fortunelabs-io/fortunelabs-mainboard-l/hardware/fortunelabs_mainboard_v0/fortunelabs_mainboard_v0.kicad_sch

## KiCad design hardware/fortunelabs_mainboard_v0/fortunelabs_mainboard_v0.kicad_sch (2026-08-21, an earlier design)

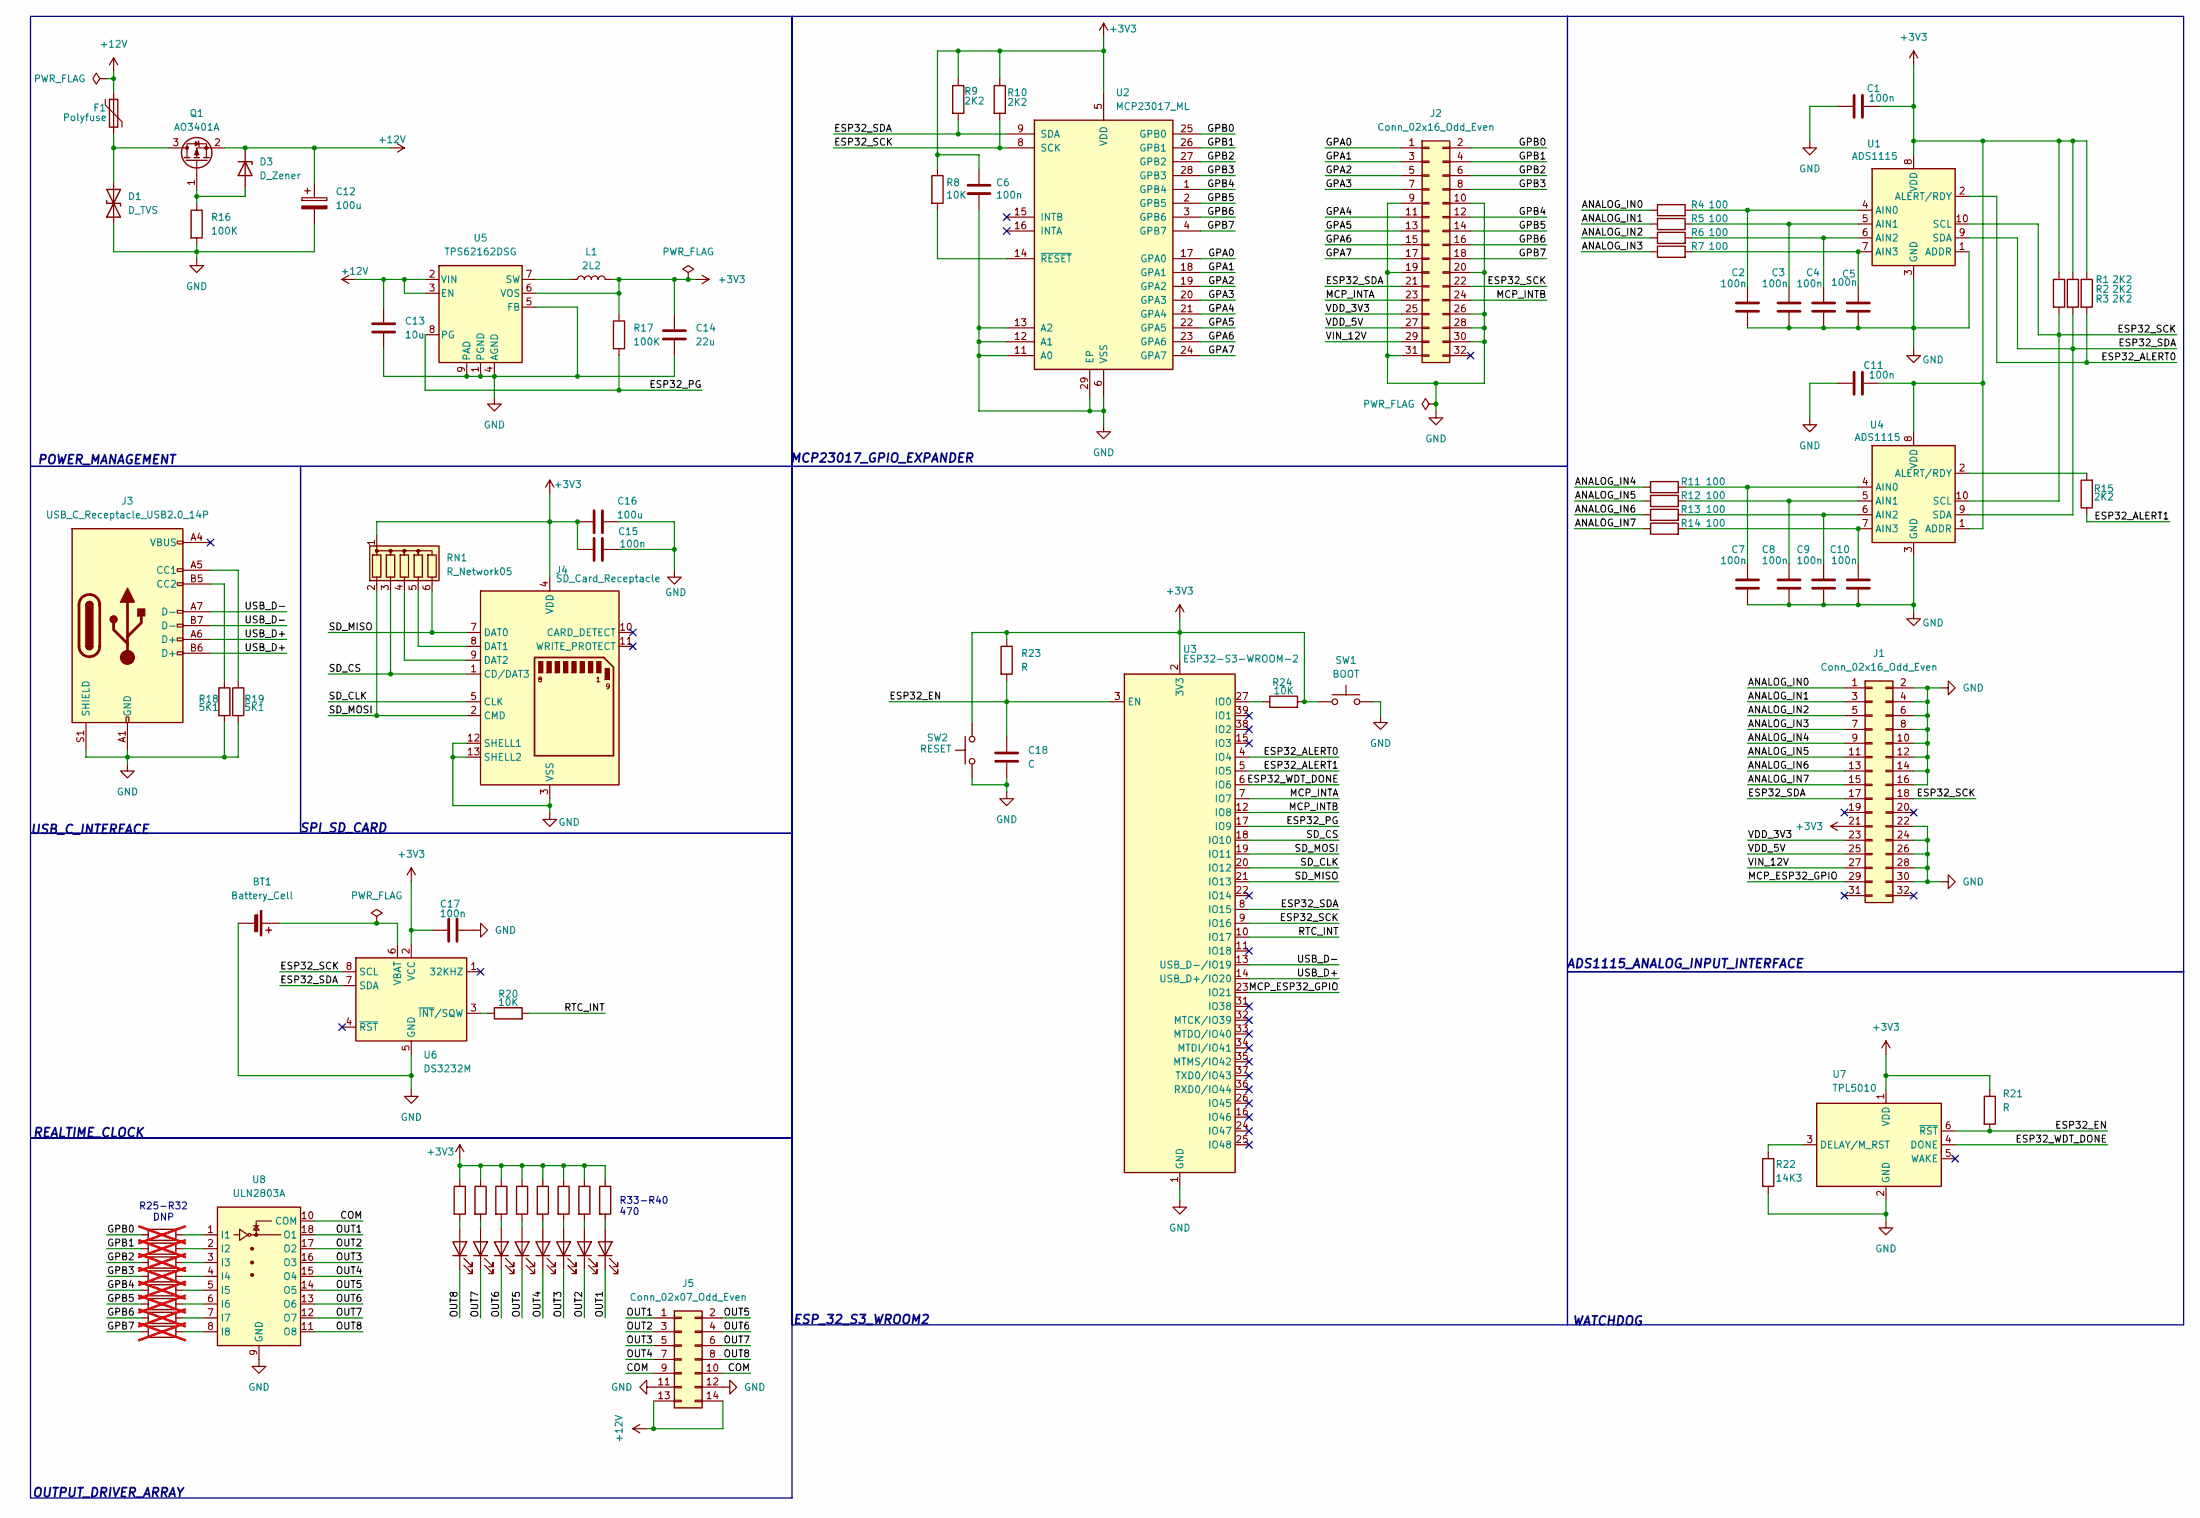
[picture p1: schematic fortunelabs_mainboard_v0.kicad_sch]

Parts:
BT1: Battery_Cell; BatteryHolder_Keystone_3002_1x2032
C1, C2, C3, C4, C5, C6, C7, C8, C9, C10, C11, C15, C17: 100n
C12, C16: 100u
C13: 10u
C14: 22u
C18: C
D1: D_TVS
D2, D4, D5, D6, D7, D8, D9: LED
D3: D_Zener
D10: LED; LED_0805_2012Metric
F1: Polyfuse
J1, J2: Conn_02x16_Odd_Even
J3: USB_C_Receptacle_USB2.0_14P
J4: SD_Card_Receptacle
J5: Conn_02x07_Odd_Even
L1: 2L2
Q1: AO3401A; SOT-23
R1, R2, R3, R9, R10, R15: 2K2
R4, R5, R6, R7, R11, R12, R13, R14: 100
R8, R20, R24: 10K
R16, R17: 100K
R18, R19: 5K1
R21, R23: R
R22: 14K3
R25, R26, R27, R28, R29, R30, R31, R32: DNP; not fitted
R33, R34, R35, R36, R37, R38, R39, R40: 470
RN1: R_Network05; R_Array_SIP6
SW1: BOOT
SW2: RESET
U1, U4: ADS1115; TSSOP-10_3x3mm_P0.5mm
U2: MCP23017_ML; QFN-28-1EP_6x6mm_P0.65mm_EP4.25x4.25mm
U3: ESP32-S3-WROOM-2
U5: TPS62162DSG; WSON-8-1EP_2x2mm_P0.5mm_EP0.9x1.6mm_ThermalVias
U6: DS3232M; SOIC-8_3.9x4.9mm_P1.27mm
U7: TPL5010; SOT-23-6
U8: ULN2803A

Connections:
+3V3: C1.1, C6.1, C11.1, C14.2, C15.1, C16.1, C17.1, J1.21, J4.4 (VDD), L1.2, R1.1, R2.1, R3.1, R8.1, R9.1, R10.1, R17.1, R21.1, R23.1, R24.2, R33.1, R34.1, R35.1, R36.1, R37.1, R38.1, R39.1, R40.1, RN1.1 (common), SW1.1, SW2.2, U1.8 (VDD), U2.5 (VDD), U3.2 (3V3), U4.1 (ADDR), U4.8 (VDD), U5.6 (VOS), U6.2 (VCC), U7.1 (VDD)
+12V: C12.1, C13.1, D3.1 (K), F1.1, J5.13, J5.14, Q1.2 (S), U5.2 (VIN), U5.3 (EN)
ANALOG_IN0: J1.1, R4.1
ANALOG_IN1: J1.3, R5.1
ANALOG_IN2: J1.5, R6.1
ANALOG_IN3: J1.7, R7.1
ANALOG_IN4: J1.9, R11.1
ANALOG_IN5: J1.11, R12.1
ANALOG_IN6: J1.13, R13.1
ANALOG_IN7: J1.15, R14.1
COM: J5.9, J5.10, U8.10 (COM)
ESP32_ALERT0: R1.2, U1.2 (ALERT/RDY), U3.4 (IO4)
ESP32_ALERT1: R15.1, U3.5 (IO5)
ESP32_EN: C18.1, R21.2, R23.2, U3.3 (EN), U7.6 (~RST)
ESP32_PG: R17.2, U3.17 (IO9), U5.8 (PG)
ESP32_SCK: J1.18, J2.22, R3.2, R10.2, U1.10 (SCL), U2.8 (SCK), U3.9 (IO16), U4.10 (SCL), U6.8 (SCL)
ESP32_SDA: J1.17, J2.21, R2.2, R9.2, U1.9 (SDA), U2.9 (SDA), U3.8 (IO15), U4.9 (SDA), U6.7 (SDA)
ESP32_WDT_DONE: U3.6 (IO6), U7.4 (DONE)
GND: BT1.2 (-), C1.2, C2.2, C3.2, C4.2, C5.2, C6.2, C7.2, C8.2, C9.2, C10.2, C11.2, C12.2, C13.2, C14.1, C15.2, C16.2, C17.2, C18.2, D1.1 (A1), J1.2, J1.4, J1.6, J1.8, J1.10, J1.12, J1.14, J1.16, J1.22, J1.24, J1.26, J1.28, J1.30, J2.9, J2.10, J2.19, J2.20, J2.26, J2.28, J2.30, J2.31, J3.A1 (GND), J3.A12 (GND), J3.B1 (GND), J3.B12 (GND), J3.S1 (SHIELD), J4.3 (VSS), J4.6 (VSS), J4.12 (SHELL1), J4.13 (SHELL2), J5.11, J5.12, R16.2, R18.2, R19.2, R22.2, SW1.2, SW2.1, U1.1 (ADDR), U1.3 (GND), U2.6 (VSS), U2.11 (A0), U2.12 (A1), U2.13 (A2), U2.29 (EP), U3.1 (GND), U3.40 (GND), U3.41 (GND), U4.3 (GND), U5.1 (PGND), U5.4 (AGND), U5.5 (FB), U5.9 (PAD), U6.5 (GND), U7.2 (GND), U8.9 (GND)
GPA0: J2.1, U2.17 (GPA0)
GPA1: J2.3, U2.18 (GPA1)
GPA2: J2.5, U2.19 (GPA2)
GPA3: J2.7, U2.20 (GPA3)
GPA4: J2.11, U2.21 (GPA4)
GPA5: J2.13, U2.22 (GPA5)
GPA6: J2.15, U2.23 (GPA6)
GPA7: J2.17, U2.24 (GPA7)
GPB0: J2.2, R25.1, U2.25 (GPB0)
GPB1: J2.4, R26.1, U2.26 (GPB1)
GPB2: J2.6, R27.1, U2.27 (GPB2)
GPB3: J2.8, R28.1, U2.28 (GPB3)
GPB4: J2.12, R29.1, U2.1 (GPB4)
GPB5: J2.14, R30.1, U2.2 (GPB5)
GPB6: J2.16, R31.1, U2.3 (GPB6)
GPB7: J2.18, R32.1, U2.4 (GPB7)
MCP_ESP32_GPIO: J1.29, U3.23 (IO21)
MCP_INTA: J2.23, U3.7 (IO7)
MCP_INTB: J2.24, U3.12 (IO8)
unnamed: BT1.1 (+), U6.6 (VBAT)
unnamed: C2.1, R4.2, U1.4 (AIN0)
unnamed: C3.1, R5.2, U1.5 (AIN1)
unnamed: C4.1, R6.2, U1.6 (AIN2)
unnamed: C5.1, R7.2, U1.7 (AIN3)
unnamed: C7.1, R11.2, U4.4 (AIN0)
unnamed: C8.1, R12.2, U4.5 (AIN1)
unnamed: C9.1, R13.2, U4.6 (AIN2)
unnamed: C10.1, R14.2, U4.7 (AIN3)
unnamed: D1.2 (A2), F1.2, Q1.3 (D)
unnamed: D2.2 (A), R33.2
unnamed: D3.2 (A), Q1.1 (G), R16.1
unnamed: D4.2 (A), R34.2
unnamed: D5.2 (A), R35.2
unnamed: D6.2 (A), R36.2
unnamed: D7.2 (A), R37.2
unnamed: D8.2 (A), R38.2
unnamed: D9.2 (A), R39.2
unnamed: D10.2 (A), R40.2
unnamed: J3.A4 (VBUS), J3.A9 (VBUS), J3.B4 (VBUS), J3.B9 (VBUS)
unnamed: J3.A5 (CC1), R19.1
unnamed: J3.B5 (CC2), R18.1
unnamed: J4.8 (DAT1), RN1.5 (R4)
unnamed: J4.9 (DAT2), RN1.4 (R3)
unnamed: L1.1, U5.7 (SW)
unnamed: R8.2, U2.14 (~RESET)
unnamed: R15.2, U4.2 (ALERT/RDY)
unnamed: R20.1, U6.3 (~INT/SQW)
unnamed: R22.1, U7.3 (DELAY/M_RST)
unnamed: R24.1, U3.27 (IO0)
unnamed: R25.2, U8.1 (I1)
unnamed: R26.2, U8.2 (I2)
unnamed: R27.2, U8.3 (I3)
unnamed: R28.2, U8.4 (I4)
unnamed: R29.2, U8.5 (I5)
unnamed: R30.2, U8.6 (I6)
unnamed: R31.2, U8.7 (I7)
unnamed: R32.2, U8.8 (I8)
OUT1: D10.1 (K), J5.1, U8.18 (O1)
OUT2: D9.1 (K), J5.3, U8.17 (O2)
OUT3: D8.1 (K), J5.5, U8.16 (O3)
OUT4: D7.1 (K), J5.7, U8.15 (O4)
OUT5: D6.1 (K), J5.2, U8.14 (O5)
OUT6: D5.1 (K), J5.4, U8.13 (O6)
OUT7: D4.1 (K), J5.6, U8.12 (O7)
OUT8: D2.1 (K), J5.8, U8.11 (O8)
RTC_INT: R20.2, U3.10 (IO17)
SD_CLK: J4.5 (CLK), U3.20 (IO12)
SD_CS: J4.1 (CD/DAT3), RN1.3 (R2), U3.18 (IO10)
SD_MISO: J4.7 (DAT0), RN1.6 (R5), U3.21 (IO13)
SD_MOSI: J4.2 (CMD), RN1.2 (R1), U3.19 (IO11)
USB_D+: J3.A6 (D+), J3.B6 (D+), U3.14 (USB_D+/IO20)
USB_D-: J3.A7 (D-), J3.B7 (D-), U3.13 (USB_D-/IO19)
VDD_3V3: J1.23, J2.25
VDD_5V: J1.25, J2.27
VIN_12V: J1.27, J2.29

Notes on the sheet:
R33-R40 470
MCP23017_GPIO_EXPANDER
ADS1115_ANALOG_INPUT_INTERFACE
POWER_MANAGEMENT
ESP_32_S3_WROOM2
USB_C_INTERFACE
WATCHDOG
OUTPUT_DRIVER_ARRAY
SPI_SD_CARD
R25-R32 DNP
REALTIME_CLOCK
