fortunelabs-io/fortunelabs-mainboard-l/(commit log)

2026-07-07 refactor: i2c bus defense mechanism and adding abstaction in IOCON.BANK1 MCP23017
2026-07-07 feat: init SIL test for i2c pipeline
2026-07-08 fix: resolving SIL symlink dir
    [ads1115.c, ads1115.h, esp_err.h, esp_log.h, mcp23017.c, mcp23017.h]
2026-07-21 feat(hardware): add KiCad mainboard v0 project with git workflow
    - fortunelabs_mainboard_v0.kicad_pro/sch/pcb
    - .gitignore for KiCad backups, autosave, local prefs
    - CI workflow (ERC/DRC + gerber/BOM export) via kicad-cli 9.0
    - README documenting the hardware git workflow
    [fortunelabs_mainboard_v0.kicad_pcb, fortunelabs_mainboard_v0.kicad_sch]
2026-07-21 refactor(firmware): architectural change on driver layer and sequence
2026-07-21 fix(hardware): ignore KiCad .lck lock files, untrack accidentally committed one
2026-07-21 feat(hardware): ads1115 schema polish
    [fortunelabs_mainboard_v0.kicad_sch]
2026-07-27 feat: add ic block scaffold
    [fortunelabs_mainboard_v0.kicad_sch]
2026-07-27 feat: designing mcp23017 init schematic
    [fortunelabs_mainboard_v0.kicad_sch]
2026-07-27 refactor: changing pin to Conn_02x04_Odd_Even and restructure ground location
    [fortunelabs_mainboard_v0.kicad_sch]
2026-07-28 refactor: restructure i2c IO
    [fortunelabs_mainboard_v0.kicad_sch]
2026-07-29 feat: adding power management module
    [fortunelabs_mainboard_v0.kicad_sch]
2026-07-29 feat: adding usb c module
    [fortunelabs_mainboard_v0.kicad_sch]
2026-07-30 feat: finshing schematic for v0.2
    [fortunelabs_mainboard_v0.kicad_sch]
2026-08-08 add LICENSE
    [fortunelabs_mainboard_v0.csv, fortunelabs_mainboard_v0.kicad_pcb, fortunelabs_mainboard_v0.kicad_sch]
2026-08-08 chore: tidy firmware root
    - sdkconfig.ci: empty since it arrived with the hello_world template in
    30c4715, never given content, referenced by no build file or workflow
    - sdkconfig.old: stale 2026-06-08 backup superseded by the current
    sdkconfig; already gitignored, so removed from disk only
2026-08-08 docs: rewrite firmware readme as architecture reference
    The firmware readme promised an architecture picture and delivered build
    instructions: ~40 of 78 lines were build/flash mechanics, and the
    Architecture section was a single paragraph deferring everything to
    GOLD_STANDARD.md. That file has never existed in this repo, nor have
    task_list.md or FINDINGS.md, also cited. The rationale the doc pointed
    at lived nowhere.
    Restructured around the layer map and the reasoning behind it:
    - Layer diagram and the dependency rule (tasks depend on hal/ contracts,
    drivers implement them, main.c is the only file naming a chip)
    - Six design decisions with rationale, including the vtable refactor
    that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
2026-08-11 docs: add git and issue SOPs, ADR index and the inner-vtable record
    The SOPs state what the history is for: which commit produced this behaviour,
    and what the board was when it did. Branch and commit vocabulary, the two
    atomicity rules, and the rule that a gate issue is opened before the run that
    tests it.
    The ADR records a decision taken on 2026-07-21 and not written down at the
    time. Its source is changelog_2026_07_21.md, deleted from the repository root
    in b49fec1 and recovered from 67a5010: the de-vtable refactor landed with the
    build green and 59 native tests passing, then was reverted the same day
    because the flat drivers read worse. It supersedes the removed
    firmware/gold_standard.md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
2026-08-11 ci: move the KiCad workflow to the repository root
    GitHub only runs workflows from .github/workflows/ at the root, so the copy
    under hardware/ never fired. Also corrects a comment in build.yml that cited
    EXIT_AUDIT_REPORT.md, a file no longer in the repository; the sdkconfig target
    discrepancy is documented in firmware/Readme.md instead.
2026-08-11 docs(hardware): tighten the KiCad git workflow guide
    Translates the .gitignore comments and reworks the workflow guide. The
    reasoning for each KiCad ignore rule stays next to the rule it explains.
2026-08-11 docs: state the repository in English, without em dashes
    The task list was written in mixed Indonesian and English. It is the
    specification every issue links to, so it is the one document that cannot
    be read only by its author. Translated in full, with every technical value,
    heading number and checkbox left as it stood.
    Two places quoted the task list in its original language and now quote the
    new wording: the prototyping principle in issue_sop.md, and the Phase 6
    power prediction.
    Em dashes replaced throughout with the punctuation each clause wanted.
    Two of those replacements change a convention rather than formatting:
    - Issue titles are now `P<phase> <handle>: <claim>`, not ` — <claim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
2026-08-11 docs(firmware): translate remaining comments, drop em dashes
    Four comments were still Indonesian: the .clang-format note on the
    alignment options, and three inline comments in main.c covering the ADC
    channel, the heartbeat period and the watchdog timeout. Em dashes in
    Readme.md and the main.c doc blocks replaced with plain punctuation.
    Comments only. No behaviour changes and no build was run.
    [main.c]
2026-08-11 docs: replace the per-phase board rule with the code/non-code split
    The tracker now runs two standing boards, split by what closing an issue
    produces: a commit, or a number that exists nowhere but the issue. The
    per-phase board it replaces is kept as a Superseded section rather than
    deleted, since the reason it was dropped is the argument for the split.
    Records the two rules that changed with it. An issue joins its board when
    opened rather than when it stops being blocked, because two standing
    boards leave a blocked issue nowhere else to wait. And a type:decision
    issue is always non-code whatever its area, because it closes as an ADR.
    The old Phase 4 project this section linked to was empt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
2026-08-17 spec: state the bare-boot constraint and the SSD1306 on the bus
    Phase 1 is specified against a bare ESP32, but the firmware aborts boot when
    an I2C device is absent, so none of its deliverables can be observed. State
    the constraint the phase depends on: driver init degrades and skips the
    dependent task rather than stopping the system. The abort-vs-degrade choice
    itself is a Decision Log entry, not settled here.
    Add the SSD1306 at 0x3C to the Phase 2 wiring and scan lists. main.c has
    required it since the display task landed; the list predates that and was
    wrong, not merely incomplete.
    Correct the Phase 1.1 task names to the ones that exist and add task_display.
    Note that the I2C rate is se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
2026-08-17 adr(hardware): record the single-stage TPS62162 rail, as Proposed
    The schematic has carried a TPS62162 since 767e999 while the specification
    still named an MP2393 to MP2388 pair down to component values. No MPS part
    appears anywhere in the schematic. Phase 6's power budget and two Risk Tracker
    rows were therefore written against parts that are not on the board.
    The record is Proposed and cannot be Accepted as written. What was chosen is
    verifiable from the BOM; why is recoverable from nothing in this repository,
    so the Alternatives section is reconstructed rather than used, and a
    reconstructed payload is not the payload. Three open items are named,
    including one that could still change the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
2026-08-17 adr(hardware): accept the TPS62162 rail, sourced on stock, with no 5V rail
    The rationale is supplied: the MPS parts could not be sourced. That is a
    sourcing fact and the record says so, so it cannot later be read as a
    considered technical comparison that never happened. Status moves to Accepted.
    Nothing on the board needs 5V. A netlist export settles what reading the sheet
    could not: U5 pin 6 sits on +3V3, so the part is fixed-output and sensing
    itself, and U8 has no supply pin at all, with COM brought out to J5 beside real
    +12V. Relays run from 12V through J5. Phase 5's 5V coil and separate 5V rail
    are corrected to match.
    The same export found three dead nets. VDD_3V3, VDD_5V and VIN_12V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
2026-08-17 hw(hardware): put EN and BOOT on their own nets, off the 3V3 rail
    SW2 (RESET) and SW1 (BOOT) each sat directly across +3V3 and GND, so
    either button shorted the rail when pressed. C18 sat across the rail as
    well, leaving EN with a pull-up and no delay capacitor.
    EN is now R21 (10K to +3V3), C18 (100n to GND), SW2 to GND, and U7 pin 6.
    BOOT is now R24 (10K to +3V3) and SW1 to GND on U3 pin 27. Neither switch
    touches +3V3.
    R23 is removed: it was a second 10K pull-up in parallel with R21, halving
    the EN time constant against C18 for no gain. R21 stays because U7's RSTn
    is open collector and requires it.
    SW1's left pin is routed around R24 at y=144.78 to reach the IO0 side; the
    EN and IO0 spa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
    [fortunelabs_mainboard_v0.kicad_sch]
2026-08-18 fix(firmware): read on the bus with i2c_master_receive
    i2c_bus_read() called i2c_master_transmit() on both the primary path and
    the post-recovery retry, so it sent the caller's buffer onto the bus and
    left it unchanged. A caller got back whatever it had passed in, with
    ESP_OK, and no way to tell.
    Latent so far: every driver in the tree reaches the bus through
    i2c_bus_write_read(), which already used i2c_master_transmit_receive()
    correctly. The first driver needing a bare read would have got silent
    garbage rather than an error.
    No prediction to hold or fail: the issue was found by reading the tree,
    not by a run. Verified by `idf.py build` (clean, links) and `pio test -e
    native` (59/59 pass)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
    [i2c_bus.c]
2026-08-18 fix(firmware): drop the never-defined g_queue_comm declaration
    app_types.h declared `extern QueueHandle_t g_queue_comm;` with no
    translation unit defining it: a link error waiting for its first
    reference. main.c allocates g_queue_display and g_queue_actuator and
    nothing else.
    The issue offered two resolutions. This takes the second: the
    declaration goes. The queue is not defined and used here because the
    one consumer that would drain it is telemetry, and telemetry reads
    sensor state through `task_sensor_get_latest_voltage()` instead
    (#5). Wiring the queue is that issue's deliverable, not this one's;
    it will reintroduce the declaration alongside the definition and the
    producer and consumer t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
2026-08-18 fix(firmware): match broker commands exactly, not by prefix
    `strncmp(data, "ON", data_len)` bounded the comparison by the payload
    rather than by the literal, so any prefix of a valid command was
    accepted: a 1-byte "O" switched the actuator on, as did any payload
    beginning "ON". The bound belongs to the literal. Check the length
    first, then compare the whole word.
    Both branches needed the guard, not just the first. Fixing "ON"
    alone would have left "O" falling through to the "OFF" branch, where
    strncmp(data, "OFF", 1) compares one byte and matches — turning a
    spurious on into a spurious off rather than removing it.
    This is the path a truncated or malformed broker message reaches
    first; pa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
    [main.c]
2026-08-18 fix(firmware): call ssd1306_clear_hw directly from init, not via the vtable
    ssd1306_init_hw() ended with `return ssd1306_driver.clear();`, dispatching
    through the driver's own public contract during its own init. The
    indirection bought nothing and made init depend on the vtable being fully
    constructed before it ran.
    The inner vtable exists for callers, per
    docs/adr/2026-07-21-ic-driver-inner-vtable.md. A driver reaching itself
    through it inverts that: the contract is the boundary, not the internal
    call path.
    ssd1306_clear_hw() is defined below init, so this adds a forward
    declaration rather than reordering the file; the Doxygen block stays at
    the definition.
    Verified: `idf.py build` passe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
2026-08-18 fix(firmware): wait for the network before attempting OTA
    ota_test_task logged "Waiting for network connection before starting OTA"
    and then called system_ota_perform() with no wait of any kind. The only
    delay was the fixed 10 s taken before the log line, so the OTA fired 10 s
    after boot regardless of association state. A reader debugging a failed
    download would have believed the network was up.
    Closing the gap rather than deleting the claim: the task now polls
    network_manager_is_connected() every 500 ms for up to 30 s, and skips the
    OTA with an error when the network never arrives. Bounded rather than
    indefinite, so a board that never associates ends with a logged reason
    instead of a task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
    [main.c]
2026-08-18 fix(firmware): disable the I2C internal pull-ups, externals are fitted
    Both master bus configurations set enable_internal_pullup = true. The
    comment on the first one, "! True if doesnt have resistor", stated the
    condition under which the value is wrong and the value was set anyway.
    The design of record fits 2.2 kOhm external pull-ups to 3.3 V. The ESP32
    internals are roughly 45 kOhm and sit in parallel with them, so leaving
    them on moves the bus rise time away from the value the externals were
    sized for, and leaves the firmware disagreeing with the schematic about
    what is on the board.
    Changed at both sites. The second is the rebuild inside
    _i2c_bus_recover_locked(), and a recovered bus is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
    [i2c_bus.c]
2026-08-18 refactor(firmware): take the display row width from the contract, not the panel
    display_msg_t.text was `char text[17]`, commented "16 characters + 1 null
    terminator for SSD1306". app_types.h is included by every task, so one
    panel's 128 px / 8 px font geometry was encoded into a type the whole
    repository depends on. Swapping to a 20-column character LCD would have
    meant editing a shared header.
    The capacity now belongs to the display HAL as DISPLAY_TEXT_MAX_LEN, which
    states what a caller may send rather than what a panel can show. Concrete
    drivers keep deriving their real width from display_config_t::width, so
    nothing about this value constrains the hardware; ssd1306_show_text_hw()
    already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
2026-08-18 fix(firmware): register the remote log sink so log lines leave the device
    system_log.c built the entire remote path and nothing connected it. The
    sink queue, the forwarder task and the vprintf hook all ran; the forwarder
    blocked for the life of the device on a queue nothing would ever be
    delivered from, because system_log_register_sink() had no caller anywhere
    in the tree. main.c called system_log_init() and stopped there.
    That is worse than the feature being absent, which is the reason this is
    an anomaly and not a chore: the code reads as though remote logging works.
    main.c now owns a sink that publishes each line to
    fortunelabs/device/<id>/log, matching the topic shape network_manager
    al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
    [main.c]
2026-08-18 refactor(firmware): carry sensor samples to telemetry on a queue
    network_manager.c declared `extern float task_sensor_get_latest_voltage(void)`
    by hand and called it to fill the telemetry payload. It was the only
    inter-task data path in the firmware that was not a FreeRTOS queue, and it
    inverted the layer map: network/ reached sideways into tasks/ through an
    extern rather than a header contract, then read a float with no
    synchronisation at all.
    g_queue_comm now carries it, which is what Phase 1.1 asked for and what the
    declaration deleted in #2 was reserved for. It comes back here with a
    definition, a producer and a consumer, which is the condition that was
    missing the first time.
    Depth 1,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
    [main.c]
2026-08-18 hw(hardware): assign footprints and correct L1 value to 2u2
    Footprint assignment pass over the v0 schematic: 75 Footprint properties
    set or corrected, leaving F1 and J4 outstanding.
    L1 carried the value "2L2", which is not valid notation for henries
    ("2R2" reads as 2.2 ohms). Corrected to "2u2", matching the 2.2 uH the
    TPS62162 application circuit calls for alongside C13 (10u) and C14 (22u).
    U8 moves from the DIP-18 SMD-socket land pattern to SOIC-18W. The
    orderable part is therefore the ULN2803ADW; the Value field still reads
    ULN2803A and is left for a separate decision.
    [fortunelabs_mainboard_v0.kicad_sch]
2026-08-18 hw(hardware): move passives to 0603 and C16 to 1210
    Every resistor and capacitor carried an imperial 0201 land pattern
    (R_0201_0603Metric, 0.6x0.3mm). The metric suffix names the same part in
    two systems and reads as 0603 at a glance, which is how the board ended
    up there while the LEDs sat on imperial 0603. 0201 is not hand-solderable
    and Phase 8 leaves self-soldering against an assembly service open, so
    the first spin should not foreclose it.
    31 resistors and 14 capacitors move to the imperial 0603 land patterns
    already used by the LEDs.
    C16 is 100u and no 0603 part of that value exists, so the sweep alone
    would have left it impossible. It takes C_1210_3225Metric, where 100u
    6.3V X5R is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
    [fortunelabs_mainboard_v0.kicad_sch]
2026-08-18 hw(hardware): give F1 the 1812 polyfuse land pattern
    F1 was the last component without a footprint apart from J4, which is
    held for the microSD change. Fuse_1812_4532Metric is the common PPTC
    land pattern in the 0.5A to 2A range this rail would use.
    This assigns a package and nothing else. F1 remains electrically inert:
    F1.1 sits on +12V and F1.2 reaches only D1.2 and Q1.3, a three-node net
    that terminates there. The 12V supply enters on J5.13/14, already on the
    +12V rail, so no current passes through the fuse, the TVS or the
    reverse-polarity FET. That is a wiring defect and is owed its own issue.
    [fortunelabs_mainboard_v0.kicad_sch]
2026-08-19 ci: run the KiCad container as root so checkout can write
    The KiCad workflow has failed on every run since it was added, always at
    the Checkout step and always within about 30 seconds, before a single
    kicad-cli command executed:
    EACCES: permission denied, open
    '/__w/_temp/_runner_file_commands/save_state_...'
    The kicad/kicad images run as the non-root "kicad" user. The Actions
    runner creates /__w/_temp owned by root, and actions/checkout writes its
    state files there, so the step cannot proceed. Running the container as
    root is the documented workaround for these images.
    Every step downstream of checkout already passes locally against KiCad
    9.0.9: ERC, DRC, gerber export, drill export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
2026-08-19 hw(hardware): rebuild the SD block around a microSD socket
    J4 was a full-size SD receptacle: a 13-pin symbol with nine contacts,
    a write-protect switch and two shell tabs. It becomes a Hirose DM3AT
    microSD socket, symbol Micro_SD_Card_Det_Hirose_DM3AT with the matching
    11-pad footprint.
    The two symbols number their pins differently, so the block was rewired
    rather than remapped. Only VDD, CLK, DAT0 and DAT1 keep their numbers;
    SD_CS moves from pin 1 to pin 2, SD_MOSI from 2 to 3, DAT2 from 9 to 1,
    and the shell tabs collapse from 12 and 13 onto pin 11. Nothing is lost:
    write-protect and card-detect were already unconnected, and both VSS pins
    were on GND, so the single VSS at pin 6 carries w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
    [fortunelabs_mainboard_v0.kicad_sch]
2026-08-19 hw(hardware): decouple the ESP32-S3 module supply pin
    U3 (ESP32-S3-WROOM-2) pin 2 3V3 carried no local capacitor. The rail's
    only reservoir was C14/C16 at the U5 buck output, shared with every
    other device on +3V3.
    Adds C19 100n 0603 and C20 22u 0805 at the 3V3 entry.
    C19 satisfies the Phase 2.1 deliverable "0.1 uF decoupling cap at the
    VDD of every IC". C20 is beyond that deliverable and is owed a
    justification: ESP32-S3-WROOM-2 datasheet v1.7, section 9 Figure 9-1
    Peripheral Schematics, shows 22 uF and 0.1 uF on VDD33 at the module
    3V3 pin. The chip-level ESP32-S3 datasheet does not cover external
    decoupling at all and cannot be cited for this.
    Sizing rationale, from ESP32-S3 datasheet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
    [fortunelabs_mainboard_v0.kicad_sch]
2026-08-19 hw(hardware): decouple the TPL5010 supply pin
    U7 (TPL5010) pin 1 VDD carried no local capacitor. Adds C21 100n 0603
    beside the module's +3V3 rail entry.
    Satisfies the Phase 2.1 deliverable "0.1 uF decoupling cap at the VDD
    of every IC" for this device. Unlike U3 this is a compliance gap
    rather than a functional risk: the TPL5010 is a nanopower timer and
    is not a meaningful transient load.
    Separated from the U3 change so either can be reverted alone.
    ERC: 0 violations.
    [fortunelabs_mainboard_v0.kicad_sch]
2026-08-19 hw(hardware): renumber R/C designators into per-block hundred bands
    Passive designators had accumulated in drawing order, not functional
    order: the ADS1115 block owned R1-R7 and C1-C5 because it was drawn
    first, power management landed at R16/R17, and the SD card block was
    split across R23 and R41-R44 as parts were tacked on. No block owned a
    contiguous range, so a designator carried no information about where it
    sat on the board.
    Each block now owns a hundred band, ordered power first, then MCU, then
    peripherals outward:
    1xx power management R101-R102 C101-C103
    2xx ESP32-S3 MCU R201 C201-C203
    3xx USB-C interface R301-R302
    4xx SPI SD card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
    [fortunelabs_mainboard_v0.kicad_sch]
2026-08-19 hw(hardware): extend designator bands to all classes, add inlet, indicators and test points
    Completes the scheme started for R/C in 6c715c6. D, F, L, Q, U, SW and J now
    carry the same per-block hundred band:
    1xx power D101-D104 F101 J101 L101 Q101 U101
    2xx MCU SW101 SW102 U201
    3xx USB-C J301
    4xx SD card J401
    5xx RTC U501
    6xx watchdog U601
    7xx GPIO exp J701 U701
    8xx analog in J801 U801 U802
    9xx output D901-D908 J901 U901
    U801/U802 is the point of the exercise: the two ADS1115 were U1 and U4, which
    actively hid that they are the same part twice.
    Test points stay flat, TP1-TP9. This is deliberate and is not an oversight to be
    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
    [fortunelabs_mainboard_v0.kicad_sch]
2026-08-20 hw(hardware): connect MCP23017 INTA/INTB to the ESP32
    U701 pins 15 and 16 carried explicit no_connect markers. The interrupt
    outputs went nowhere, so the expander could not signal a pin change and the
    ESP32 would have had to poll it over I2C.
    The nets existed and looked right. MCP_INTA and MCP_INTB ran from U201 IO7
    and IO8 to J701.23/24, so the sheet showed named interrupt lines the whole
    time; they simply never reached the chip they were named for. The
    no_connect markers are why ERC stayed quiet, a marked pin being one ERC has
    been told to ignore.
    MCP_INTA U201.7 <-> J701.23 <-> U701.16
    MCP_INTB U201.12 <-> J701.24 <-> U701.15
    Two separate GPIOs, not the wire-OR the task list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
    [fortunelabs_mainboard_v0.kicad_sch]
2026-08-20 chore(hardware): re-export the BOM from the schematic
    The CSV still carried the flat pre-band designators and had no footprints
    assigned, so it described the board as it stood before the designator
    renumber, the barrel-jack inlet, the indicators and the test points landed.
    Regenerated with kicad-cli from fortunelabs_mainboard_v0.kicad_sch using the
    export settings already stored in the project file; no cell was edited by
    hand.
    Verified against the schematic: 36 rows, 108 designators, every Qty equal to
    its reference count, and the reference set identical to the schematic's.
    kicad-cli localises field values from the KiCad language setting, which would
    have written the DNP column as "DNP (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
    [fortunelabs_mainboard_v0.csv]
2026-08-21 feat(firmware): signal a good boot on the MCU status LED
    Flashing a board proves bytes were written, not that the image runs. Add
    a status_led output driver and a task_status consumer that flashes the
    LED every 2 s for as long as the firmware is alive.
    The heartbeat starting at all is the signal. task_status is spawned last
    by app_main, so it only runs once every driver init has returned ESP_OK
    and the scheduler has reached it: a board that flashes but faults during
    init stays dark, and one that boots and later wedges stops blinking.
    There is no pattern to decode - pulsing means alive.
    The LED is driven from a native GPIO rather than the D901-D908 bank,
    which sits behind the ULN2803A and t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
2026-08-21 fix(firmware): drive the status LED from a pin that exists on esp32
    STATUS_LED_DEFAULT_GPIO was GPIO_NUM_48, chosen from the v0 schematic,
    where U201 is an ESP32-S3. Development runs on an ESP32 devkit, whose
    GPIO range stops at 39, so bb424fd does not compile on the target the
    committed sdkconfig actually selects.
    GPIO 4 replaces it: an external LED on the devkit, not a strapping pin
    (0, 2, 5, 12, 15 are), and not one of the pads that emits a PWM burst
    while the ROM bootloader runs. That last point is the reason it is not
    GPIO 14, the only pad free on both the devkit and the mainboard: a
    boot-time flicker on an LED whose whole job is to say "boot finished"
    would say it before the firmware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
    [main.c, status_led.c, status_led.h]
2026-08-21 hw(hardware): add the heartbeat LED on IO48
    D201 with R202 (2K2) in series, anode to the resistor and cathode to
    GND, driven from U201 pin 25 (IO48) on the net LED_HEART. Active high:
    the MCU sources the current.
    IO48 carries no strapping function on the ESP32-S3 and is Espressif's
    own convention for a module status LED, so a probe there means the same
    thing on this board as on a devkit. It was unconnected before this.
    This is the only indicator the MCU can drive without the I2C bus. The
    D901-D908 bank sits behind the ULN2803A and the MCP23017, so it cannot
    light before the bus is up and cannot report a fault in the I2C path
    itself. 2K2 gives roughly 0.6 mA at 3V3: dim, visible, and far in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
    [fortunelabs_mainboard_v0.kicad_sch]
2026-08-21 hw(hardware): name the power indicators by the rail they watch
    D103 becomes LED_12V and D104 becomes LED_3V3, from a shared Value of
    LED. Both sit in the power block and each one reports a different rail,
    which the schematic could not tell you before: the reader had to trace
    the anode back to find out which supply an unlit LED was accusing.
    Value is a grouping field in the BOM settings, so this also splits the
    two of them out of the ten-part LED row. That is a presentation change
    only. No net, footprint or fitment changes, and nothing here alters the
    board.
    [fortunelabs_mainboard_v0.kicad_sch]
2026-08-21 chore(hardware): re-export the BOM from the schematic
    Picks up D201 and R202, and the D103/D104 value renames. R202 joins the
    existing 2K2 group, taking it from seven to eight; D103, D104 and D201
    each leave the shared LED row and stand alone, since Value is a grouping
    field.
    Exported with kicad-cli against the settings stored in the project file
    under /schematic/bom_settings, not the tool defaults, which use a
    different column set and do not group at all. Run against a throwaway
    config home with the language forced to Default: KiCad translates field
    values from its own config rather than the environment, and this file is
    committed, so a localised cell would have to be fixed by re-exporting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
    [fortunelabs_mainboard_v0.csv]
2026-08-21 docs(firmware): record that the esp32 target is deliberate
    The Known deviations entry called the esp32 target stale from the
    hello_world template and pointed at set-target esp32s3 as the fix, and
    the build instructions opened with that command. Both read as an
    invitation to retarget. Following it breaks the build for the hardware
    actually on the bench: there is no S3 board yet, so esp32 is the only
    target that produces a flashable image, and CI matches it on purpose.
    Says so plainly, and records what compiling for esp32 costs: GPIO stops
    at 39, 34-39 are input-only, and the pin choices that look wrong against
    the schematic are right for the devkit. Someone reading main.c with the
    mainboard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
2026-08-21 hw(hardware): shrink the test point drill to 1.0mm
    TP1-TP5, TP8 and TP9 move from TestPoint_Plated_Hole_D2.0mm to
    TestPoint_THTPad_D2.0mm_Drill1.0mm. The 2.0mm hole was too large; the
    pad outer diameter stays 2.0mm, only the drill changes.
    TP6 and TP7 keep TestPoint_Loop_D2.50mm_Drill1.0mm_LowProfile. They are
    loop points, a different class, and already on a 1.0mm drill.
    The exported BOM still names the old footprint and is re-exported in a
    commit of its own. No test point footprints are placed on the PCB, so
    there is nothing to sync there.
    [fortunelabs_mainboard_v0.kicad_sch]
